jeffrey500/EMG_Board/EMG_Board_LTspice/EMG_BOARD.asc

C1: cap; 10µ
C2: cap; 100n
C3: cap; 100n
C4: cap; 100n
C5: cap; 10µ
C6: cap; 100n
R1: res; 10k
R2: res; 10k
R3: res; 5.56k
R4: res; 160k
R5: res; 1k
R6: res; 50k
R7: res; 4k
U3: INA828
U4: OPAx189
V1: voltage; 5
V2: voltage; 5
V3: voltage; SINE(0.2 .001 100); AC 1
Named nets: 0, -5, +5, output, input
51x gain
10Hz High Pass
400Hz Low Pass
10x gain
PWR
.ac dec 1000 .01 10000
.tran 0.25
