jeffrey500/EMG_Board/(commit log)

2026-08-12 updated board images
2026-08-13 removed background on Board_3D.png
2026-08-13 better Board_3D.png image with bg removed
2026-08-13 Swap images in schematic section of README
